robertrau/piflyMechanical/Tall Test.scad

cube([20,20,30]);
