robertrau/piflyMechanical/(list of files, cad)

Other CAD files:
PiZeroCutout.scad
PyFlyCutout.scad
