robertrau/piflyMechanical/(commit log)

2022-06-18 Adding source
    [FruitFlyCutout.scad, PiCam5mp1.scad, PiZeroCutout.scad, PiZero_1.2.scad, PyFlyCage.scad, PyFlyCutout.scad, Tall Test.scad]
2023-08-20 opened up camera cavity
    [PyFlyCage.scad]
2023-08-23 fixed: PCB thickness, opening for power supp mod, Deans interference, servo connector
    [PyFlyCage.scad]
2023-08-24 more tweeks needed for the boards to fit in
    [PyFlyCage.scad]
2023-08-26 more tweeking
    [PyFlyCage.scad]
2023-08-28 added camera depth offset for different lengths of lenses. added 5th mounting hole
    [PyFlyCage.scad]
